bboudaoud/TEMPO-4000/Hardware/Core Platform/Images/TEMPO4_TOP1_recolor.jpg

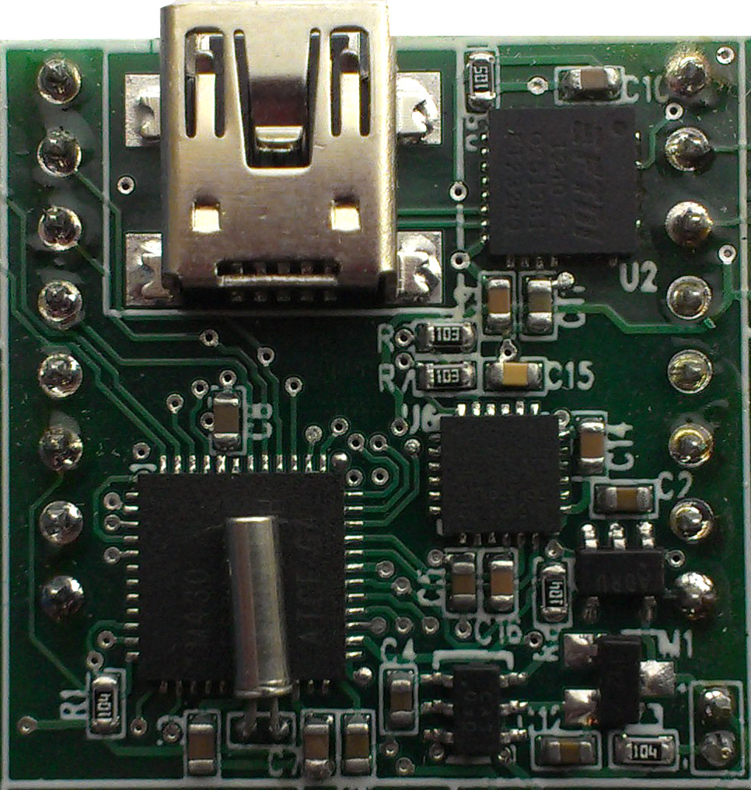
Hardware/Core Platform/Images/TEMPO4_TOP1_recolor.jpg
