bboudaoud/TEMPO-4000/Hardware/Core Platform/Images/1x1board_cam.png

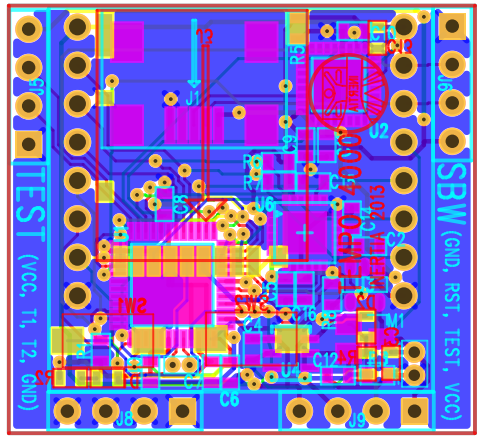
Hardware/Core Platform/Images/1x1board_cam.png
