bboudaoud/TEMPO-4000/Hardware/Core Platform/Images/TEMPO4_BOT1_recolor.jpg

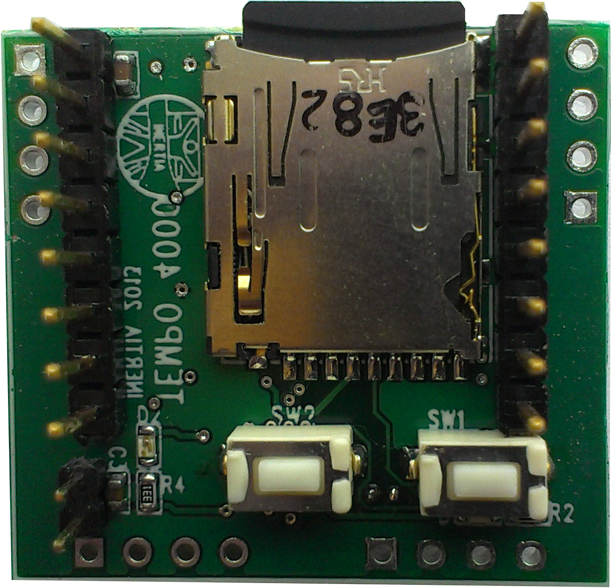
Hardware/Core Platform/Images/TEMPO4_BOT1_recolor.jpg
