bboudaoud/TEMPO-4000/Hardware/Core Platform/Images/TEMPO4_ISO1.jpg

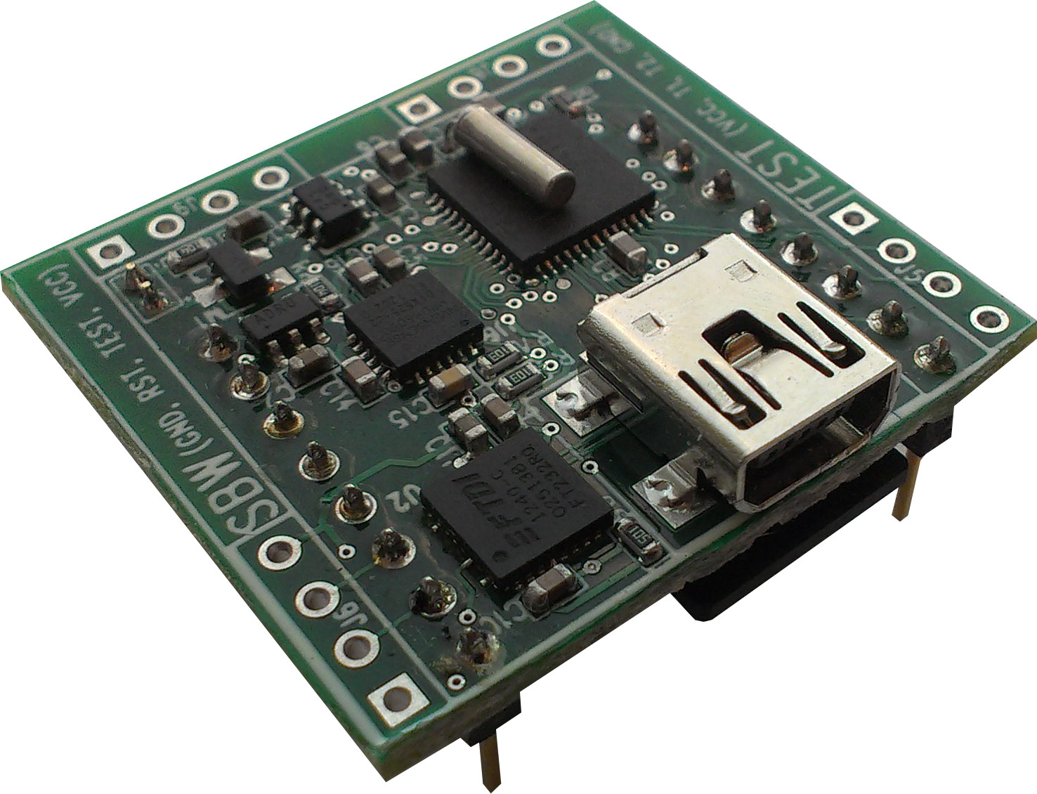
Hardware/Core Platform/Images/TEMPO4_ISO1.jpg
