bboudaoud/TEMPO-4000/Hardware/Core Platform/Images/TEMPO4_TOPBOT_LABEL.jpg

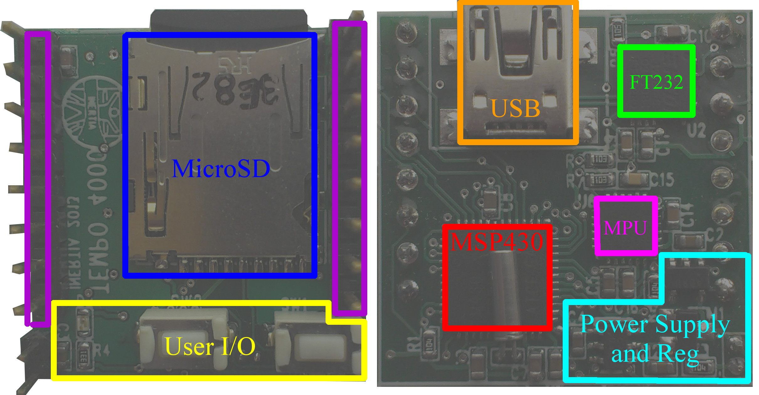
Hardware/Core Platform/Images/TEMPO4_TOPBOT_LABEL.jpg
