bboudaoud/TEMPO-4000/Hardware/Core Platform/TEMPO4k_BoM.xlsx

Item | Reference | Part Name | Qty | Manufacturer | Description | DigiKey Part # | Part Number | Unit Cost @ 1 | Unit Cost @ 10 | Unit Cost @ 100 | Unit Cost | Cost/Board | Total
1 | U4 | AP7312 | 1 | Diodes Inc. | Dual Channel 3.3V 150mA LDO | AP7312-3333W6-7DICT-ND (http://www.digikey.com/product-detail/en/AP7312-3333W6-7/AP7312-3333W6-7DICT-ND/2594053) | AP7312 | $0.64 | $0.56 | $0.43 | 0.56 | 0.56 | 6.72
2 | C9-10 C13-14 C16 | CAP0603_UNDERSIZED,100n | 5 | TDK Corporation | MILSPEC 603 CAPACITOR | 445-1316-1-ND (http://www.digikey.com/product-detail/en/C1608X7R1E104K080AA/445-1316-1-ND/567697) | C1608X7R1E104K080AA | $0.10 | $0.02 | $0.01 | 0.024 | 0.12 | 1.44
3 | C1 C7-8 | CAP0603_UNDERSIZED,10u | 3 | TDK Corporation | MILSPEC 603 CAPACITOR | 445-4112-1-ND (http://www.digikey.com/product-detail/en/C1608X5R0J106M080AB/445-4112-1-ND/1975462) | C1608X5R0J106M080AB | $0.32 | $0.26 | $0.13 | 0.26 | 0.78 | 9.36
4 | C2-5 C12 | CAP0603_UNDERSIZED,1uF | 5 | Samsung Electronics | MILSPEC 603 Capacitor | 1276-1041-1-ND (http://www.digikey.com/product-detail/en/CL10F105ZP8NNNC/1276-1041-1-ND/3889127) | CL10F105ZP8NNNC | $0.10 | $0.04 | $0.02 | 0.041 | 0.205 | 2.46
5 | C15 | CAP0603_UNDERSIZED,2.2nF | 1 | Samsung Electronics | MILSPEC 603 CAPACITOR | 1276-1110-1-ND (http://www.digikey.com/product-detail/en/CL10B222KB8NNNC/1276-1110-1-ND/3889196) | CL10B222KB8NNNC | $0.10 | $0.03 | $0.01 | 0.029 | 0.029 | 0.348
6 | C11 | CAP0603_UNDERSIZED,4.7u | 1 | Taiyo Yuden | MILSPEC 603 CAPACITOR | 587-1785-1-ND (http://www.digikey.com/product-detail/en/JMK107BJ475KA-T/587-1785-1-ND/1212801) | JMK107BJ475KA-T | $0.13 | $0.09 | $0.04 | 0.09 | 0.09 | 1.08
7 | C6 | CAP0603_UNDERSIZED,470nF | 1 | Taiyo Yuden | MILSPEC 603 CAPACITOR | 587-1259-1-ND (http://www.digikey.com/product-detail/en/TMK107F474ZA-T/587-1259-1-ND/931036) | TMK107F474ZA-T | $0.10 | $0.04 | $0.02 | 0.042 | 0.042 | 0.504
8 | J2 | CON-SIP-2P | 1 | N/A | GENERIC 2 PIN SIP HEADER .100 CENTERS | N/A | N/A
9 | J5-6 J8-9 | CON-SIP-4P | 4 | N/A | GENERIC 4 PIN SIP HEADER .100 CENTERS | N/A | N/A
10 | J1 | CON-USB-5PMINI | 1 | TE Connectivity | 5 pin Mini USB type AB connector | 732-3154-1-ND (http://www.digikey.com/product-detail/en/651305142821/732-3154-1-ND/2627307) | 651305142821 | $2.23 | $2.02 | $1.73 | 2.02 | 2.02 | 24.24
11 | X1 | CRYSTAL_0,32.768kHz | 1 | Citizen Finetech Miyota | XTAL 32.768kHz 6pF | 300-8301-ND (http://www.digikey.com/product-search/en?vendor=0&keywords=300-8301-ND) | CFS206-32.768KDZB-UB | $0.28 | $0.24 | $0.16 | 0.24 | 0.24 | 2.88
12 | U2 | FT232RQ | 1 | FTDI | USB to RS232 Converter IC | 768-1008-1-ND (http://www.digikey.com/product-detail/en/FT232RQ-REEL/768-1008-1-ND/1836403) | FT232RQ | $4.50 | $4.05 | $3.65 | 4.05 | 4.05 | 48.6
13 | D1 | LED Green | 1 | Lite-On Inc | MILSPEC 603 LED | 160-1828-1-ND (http://www.digikey.com/product-detail/en/LTST-C193KGKT-5A/160-1828-1-ND/2356247) | LTST-C193KGKT-5A | $0.42 | $0.30 | $0.18 | 0.3 | 0.3 | 3.6
14 | D2 | LED Red | 1 | Lite-On Inc | MILSPEC 603 LED | 160-1830-1-ND (http://www.digikey.com/product-detail/en/LTST-C193KRKT-5A/160-1830-1-ND/2356251) | LTST-C193KRKT-5A | $0.42 | $0.30 | $0.18 | 0.3 | 0.3 | 3.6
15 | U3 | MAX1555EZK-T | 1 | Maxim Integrated | LiPo Battery Charger IC | MAX1555EZK+TCT-ND (http://www.digikey.com/product-detail/en/MAX1555EZK%2BT/MAX1555EZK%2BTCT-ND/2699449) | MAX1555EZK+T | $2.03 | $2.03 | $1.33 | 2.03 | 2.03 | 24.36
16 | J3 | MICROSD_PUSH-PUSH | 1 | Hirose Electric Co Ltd | CONN MICRO SD R/A PUSH-PUSH SMD | HR1964CT-ND (http://www.digikey.com/product-detail/en/DM3AT-SF-PEJM5/HR1964CT-ND/2533566) | DM3AT-SF-PEJM5 | $3.26 | $2.70 | $2.00 | 2.703 | 2.703 | 32.436
17 | U6 | MPU6050 | 1 | Invensense | 6-Axis I2C Interfaced IMU | SPARKFUN or INVENSENSE DIRECTLY (https://www.sparkfun.com/products/10937) | MPU6050 | $12.95 | $11.66 | $10.36 | 11.66 | 11.66 | 139.92
18 | U1 | MSP430F5342 | 1 | Texas Instruments | 5xxx Series MSP430 Microcontroller | 296-29957-1-ND (http://www.digikey.com/product-detail/en/MSP430F5342IRGZT/296-29957-1-ND/2786087) | MSP430F5342 | $6.74 | $6.04 | $3.16 | 6.037 | 6.037 | 72.444
19 | M1 | NDS332P | 1 | Fairchild Semiconductor | SOT-23 P-CH MOSFET | NDS332PCT-ND (http://www.digikey.com/product-detail/en/NDS332P/NDS332PCT-ND/428171) | NDS332P | $0.52 | $0.37 | $0.24 | 0.37 | 0.37 | 4.44
20 | R6-7 | RES0603_UNDERSIZED,10k | 2 | Panasonic Electronic Components | MILSPEC 603 RESISTOR | P10KGCT-ND (http://www.digikey.com/product-detail/en/ERJ-3GEYJ103V/P10KGCT-ND/134717) | ERJ-3GEYJ103V | $0.10 | $0.10 | $0.07 | 0.1 | 0.2 | 2.4
21 | R1, R3, R8 | RES0603_UNDERSIZED,100k | 3 | Panasonic Electronic Components | MILSPEC 603 RESISTOR | P100KGCT-ND (http://www.digikey.com/product-detail/en/ERJ-3GEYJ104V/P100KGCT-ND/134878) | ERJ-3GEYJ104V | $0.10 | $0.10 | $0.01 | 0.1 | 0.3 | 3.6
22 | R5 | RES0603_UNDERSIZED,1M | 1 | Panasonic Electronic Components | MILSPEC 603 RESISTOR | P10KGCT-ND (http://www.digikey.com/product-detail/en/ERJ-3GEYJ103V/P10KGCT-ND/134717) | ERJ-3GEYJ103V | $0.10 | $0.10 | $0.01 | 0.1 | 0.1 | 1.2
23 | R2 R4 | RES0603_UNDERSIZED,330 | 2 | Panasonic Electronic Components | MILSPEC 603 RESISTOR | P330GCT-ND (http://www.digikey.com/product-detail/en/ERJ-3GEYJ331V/P330GCT-ND/134778) | ERJ-3GEYJ331V | $0.10 | $0.10 | $0.01 | 0.1 | 0.2 | 2.4
24 | SW1-2 | SW_PUSHBUTTON | 2 | Panasonic Electronic Components | Momentary Pushbutton SW (SMT) | P13597SCT-ND (http://www.digikey.com/product-detail/en/EVQ-PNF04M/P13597SCT-ND/1245518) | EVQ-PNF04M | $0.72 | $0.68 | $0.52 | 0.677 | 1.354 | 16.248
25 | J4 | T4000HEADER | 1 | N/A | 100 mil TEMPO 4000 16-pin header | N/A | N/A
 | Boards | 12
 | Cost/Board | $33.69
 | Total Cost | $404.28
 | Board Cost | $200
 | Population (unit) | $50
 | Population Total | $600
 | Assembly Total | $1204.28
