bboudaoud/TEMPO-4000/Hardware/Core Platform/Images/testboard_16-pin_devheader.png

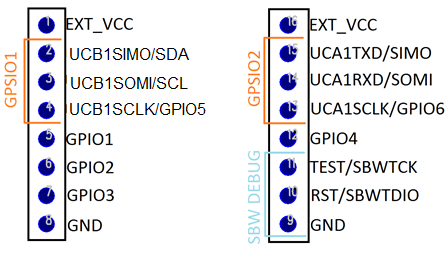
Hardware/Core Platform/Images/testboard_16-pin_devheader.png
