bboudaoud/TEMPO-4000/Hardware/Core Platform/TEMPO4k-final_DFM.pdf

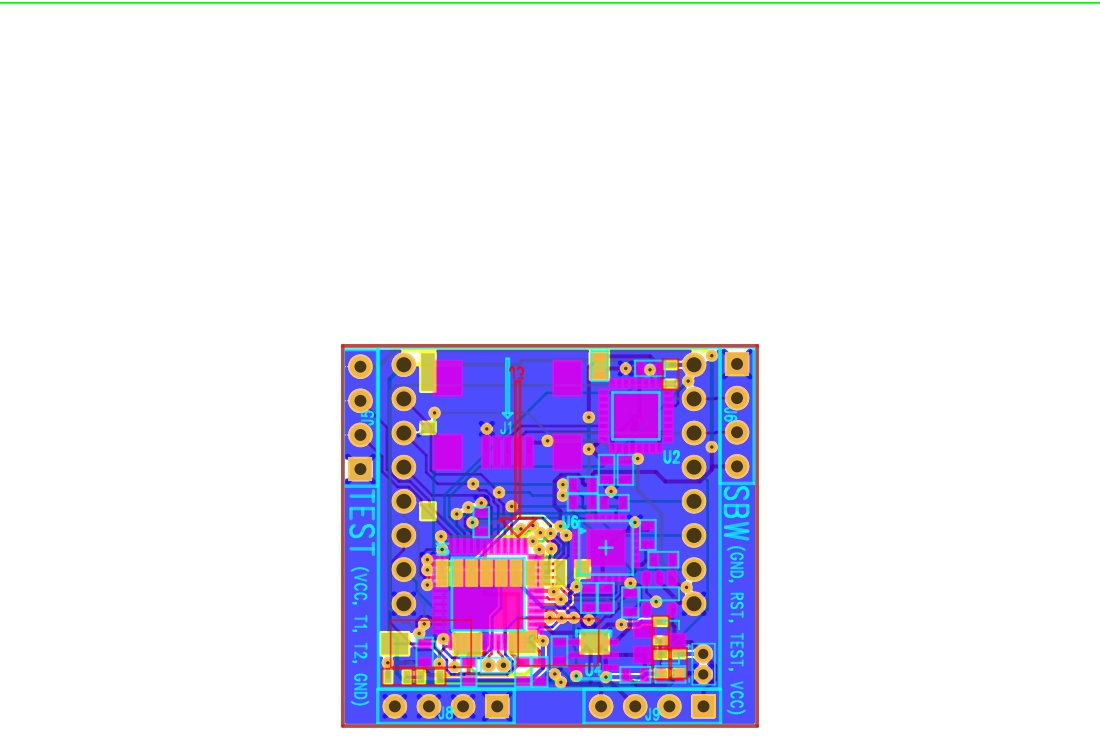
[picture p25: page 1]
