bboudaoud/TEMPO-4000/Hardware/Core Platform/TEMPO4k-final_layout.pdf

# R5R⁵x1 R⁵x2

# C10 C¹⁰x2 C¹⁰x1

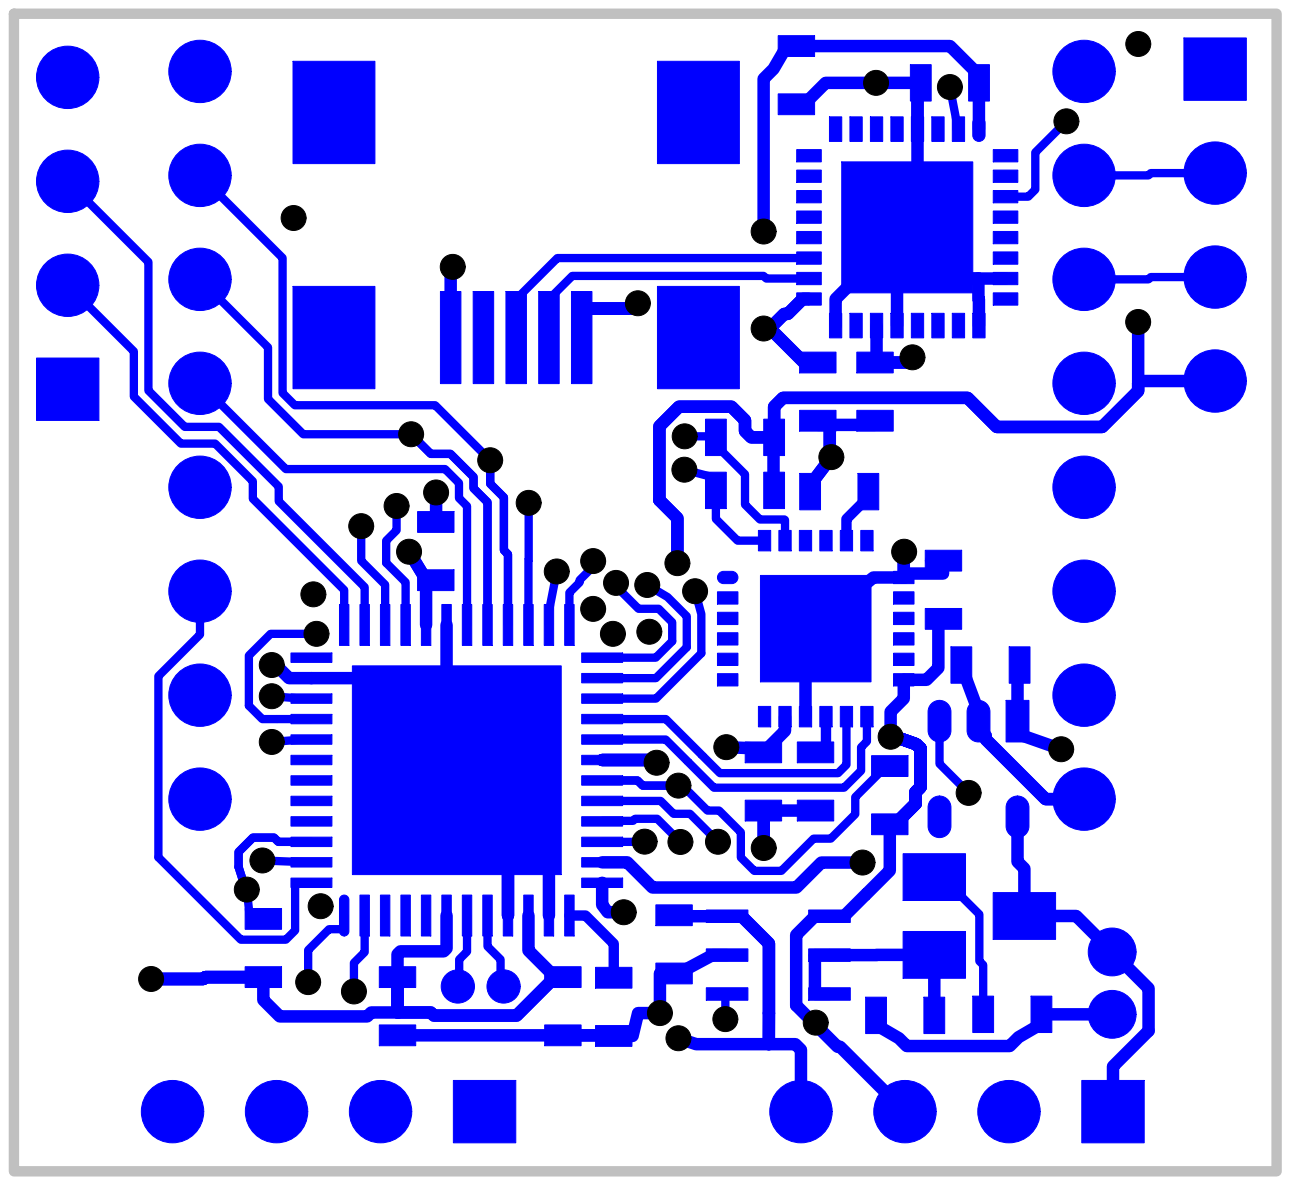
[picture p26: page 1]
U1U¹x1 U¹x2 U¹x3 U¹x4 U¹x5 U¹x6 U¹x7 U¹x8 U¹x9 U¹x10; U¹x11; U¹x12; U2U²x8 U²x7 U²x6 U²x5 U²x4 U²x3 U²x2 U²x1 U²x9 U²x10 U²x11 U²x12 U²x13 U²x14 U²x15 U²x16; U²x17; U²x18; U²x19; U²x20; U²x21; U²x22; U²x23; U²x24 U²x25 U²x26 U²x27 U²x28 U²x29 U²x30 U²x31 U²x32 U²x33; U3U³x3 U³x2 U³x1 U³x4; U³x5; C2C²x2; C²x1; U4U⁴x1 U⁴x2 U⁴x3; U⁴x4 U⁴x5 U⁴x6; C4C⁴x1 C⁴x2; C5C⁵x1 C⁵x2; C12 C¹²x2; C¹²x1; C14C¹⁴x1 C¹⁴x2; C15 C¹⁵x2; C¹⁵x1; C6C⁶x1; C8C⁸x1 J4C⁸x2 J4x1 J4x2 J4x3 J4x4 J4x5 J4x6 J4x7 J4x8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

# J5J5x1 J5x2 J5x3 J5x4

# J6J6x1 J6x2 J6x3 J6x4

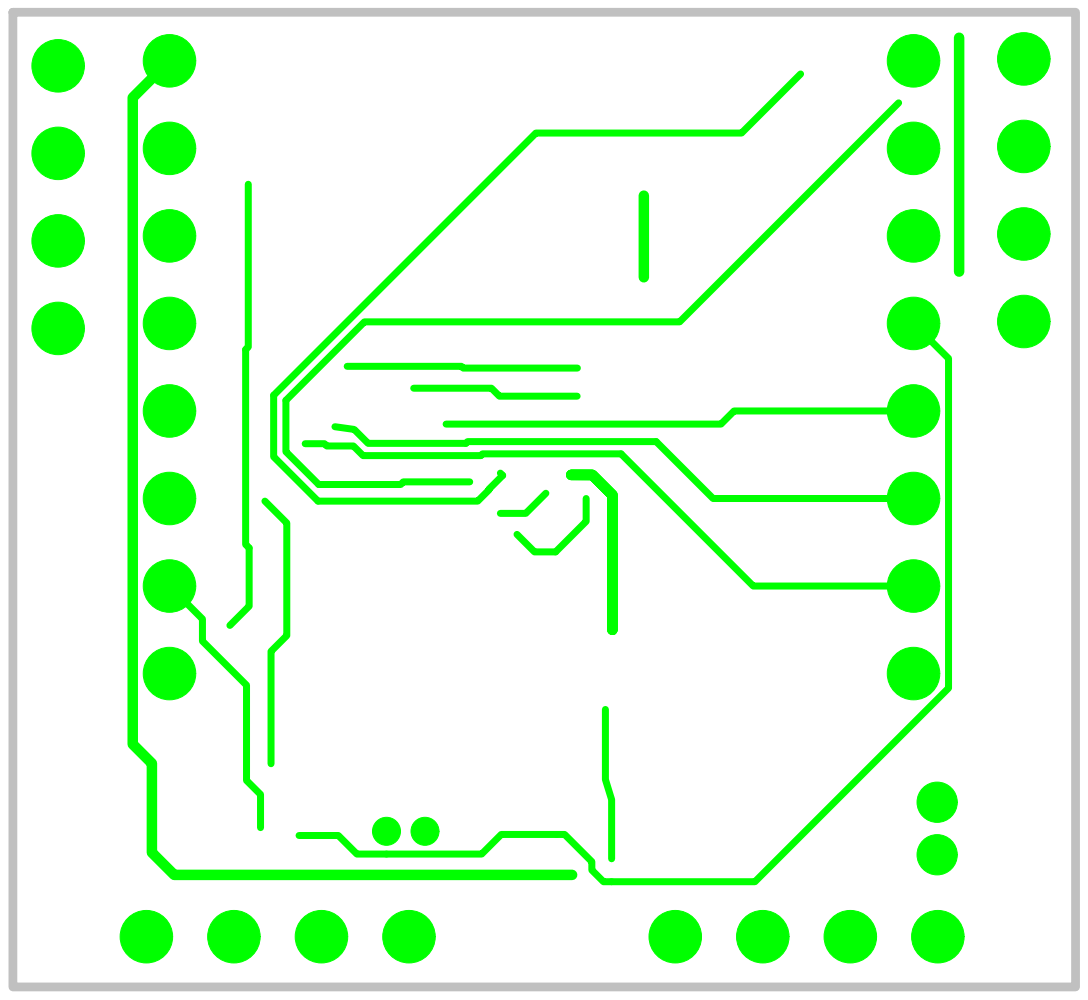
[picture p27: page 2]
X1X¹x2 X¹x1

# J5J5x1 J5x2 J5x3 J5x4

# J6J6x1 J6x2 J6x3 J6x4

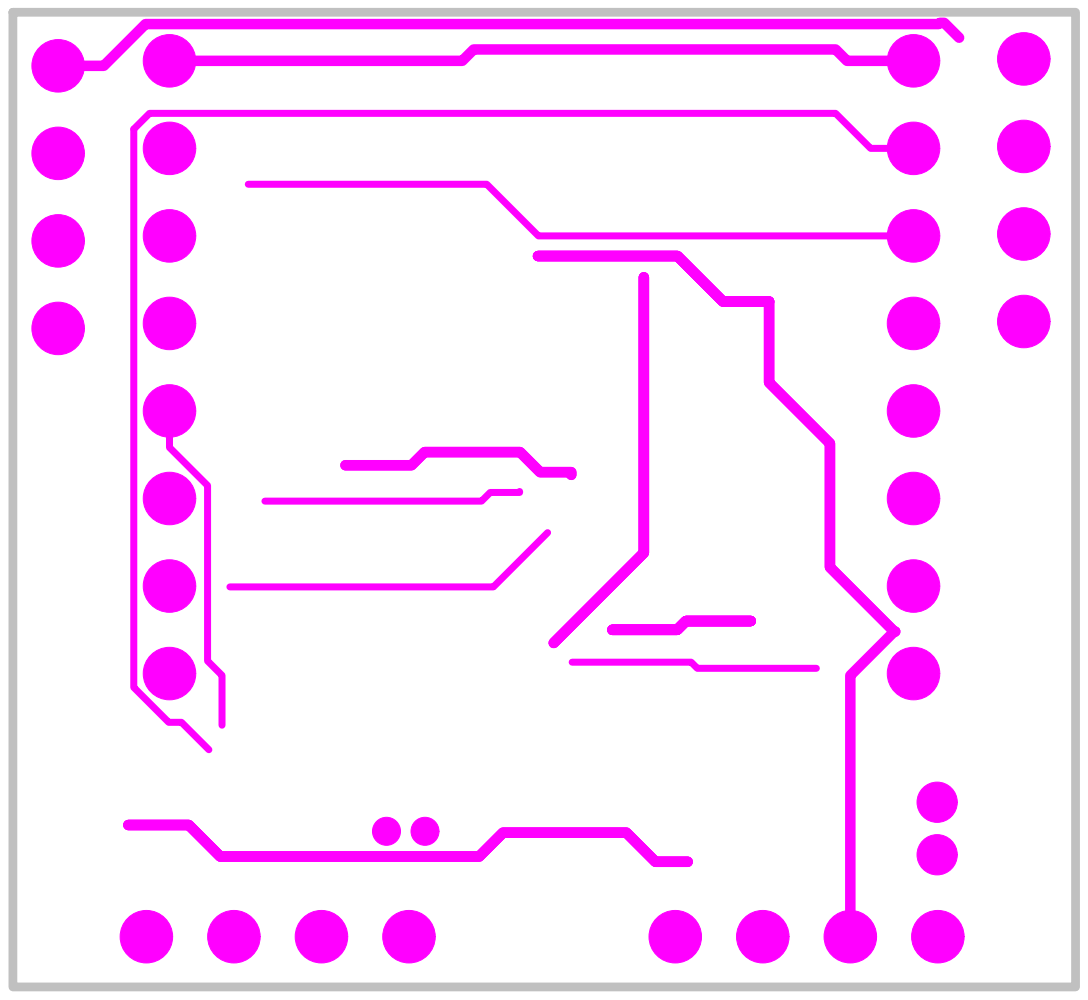
[picture p28: page 3]
X1X¹x2 X¹x1

# C13C¹³x1 C¹³x2

# J5J5x1 J5x2 J5x3 J5x4

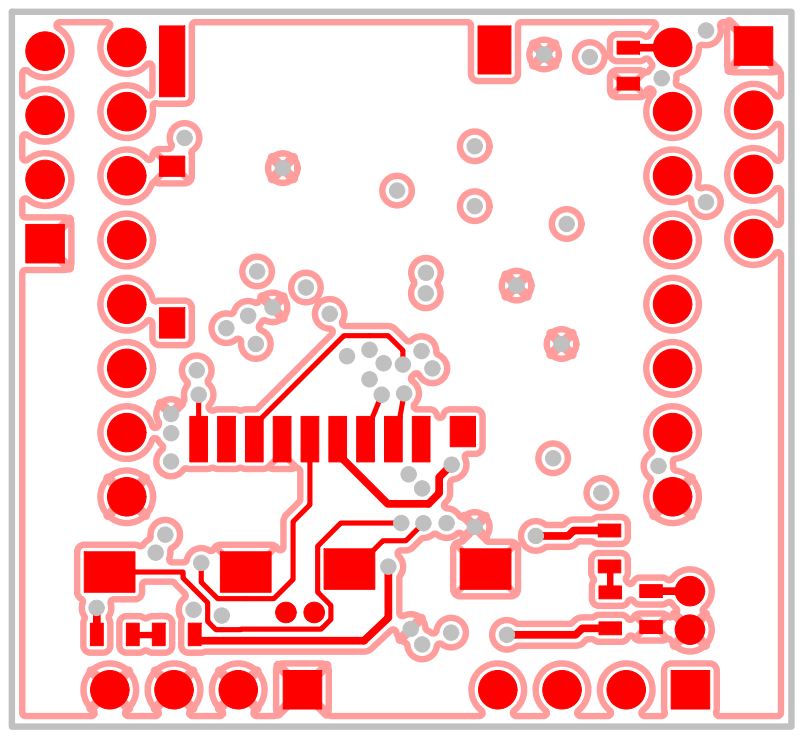
[picture p29: page 4]
C3C³x1 C³x2; D2D²x1; J4D²x2 J4x1 J4x2 J4x3 J4x4 J4x5 J4x6 J4x7 J4x8; X1X¹x2 X¹x1; R2R²x2; R²x1 D1D¹x1; D¹x2; SW2 SW²x1; SW²x2; R4R⁴x1 R⁴x2; SW1 SW¹x1; SW¹x2

R5
C10

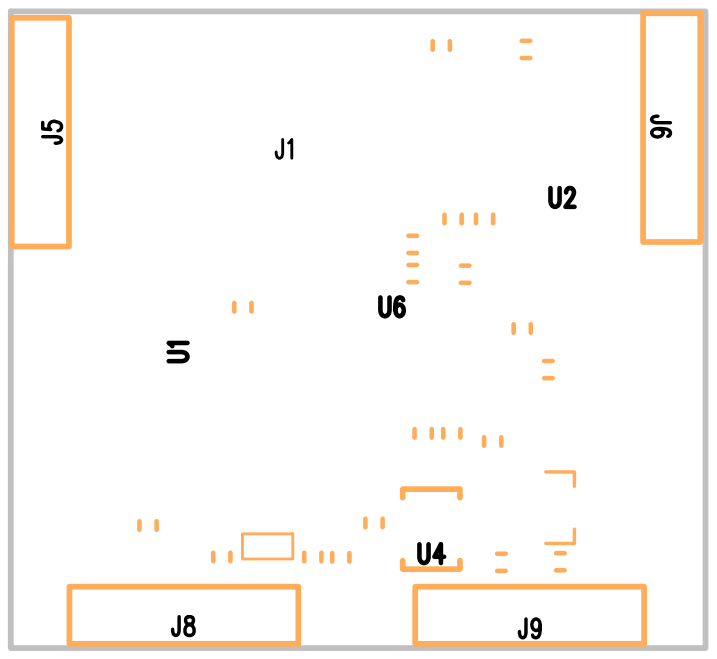
[picture p30: page 5]

J3

C3

D2

C13

# X1X¹x2 X¹x1

R2D1 | J2J2x1 J2x2
SW2 SW1 | R4

C10

1

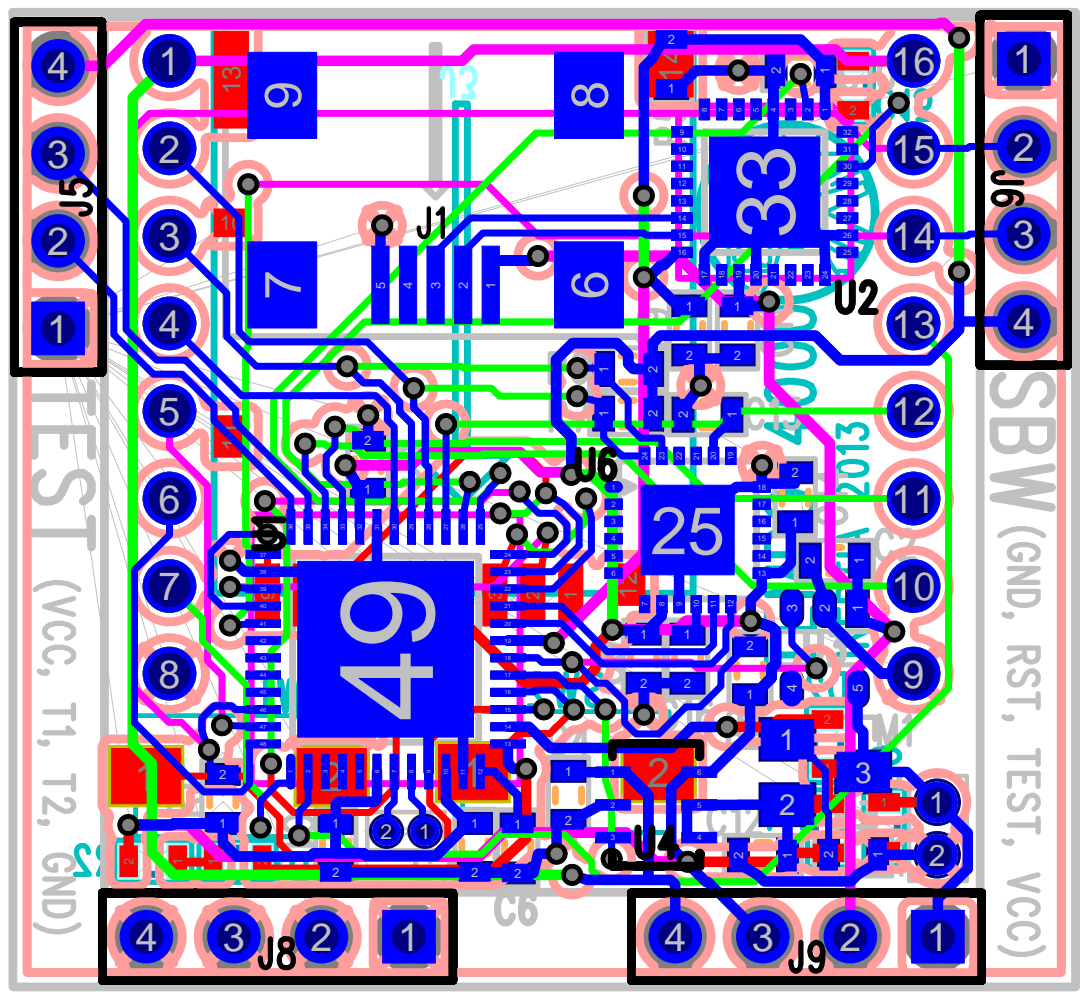
[picture p31: page 7]

SBW (GND, RST, TEST, VCC)
