bboudaoud/TEMPO-4000/Hardware/Core Platform/TEMPO4k-final_schematic.pdf

## MAX1555

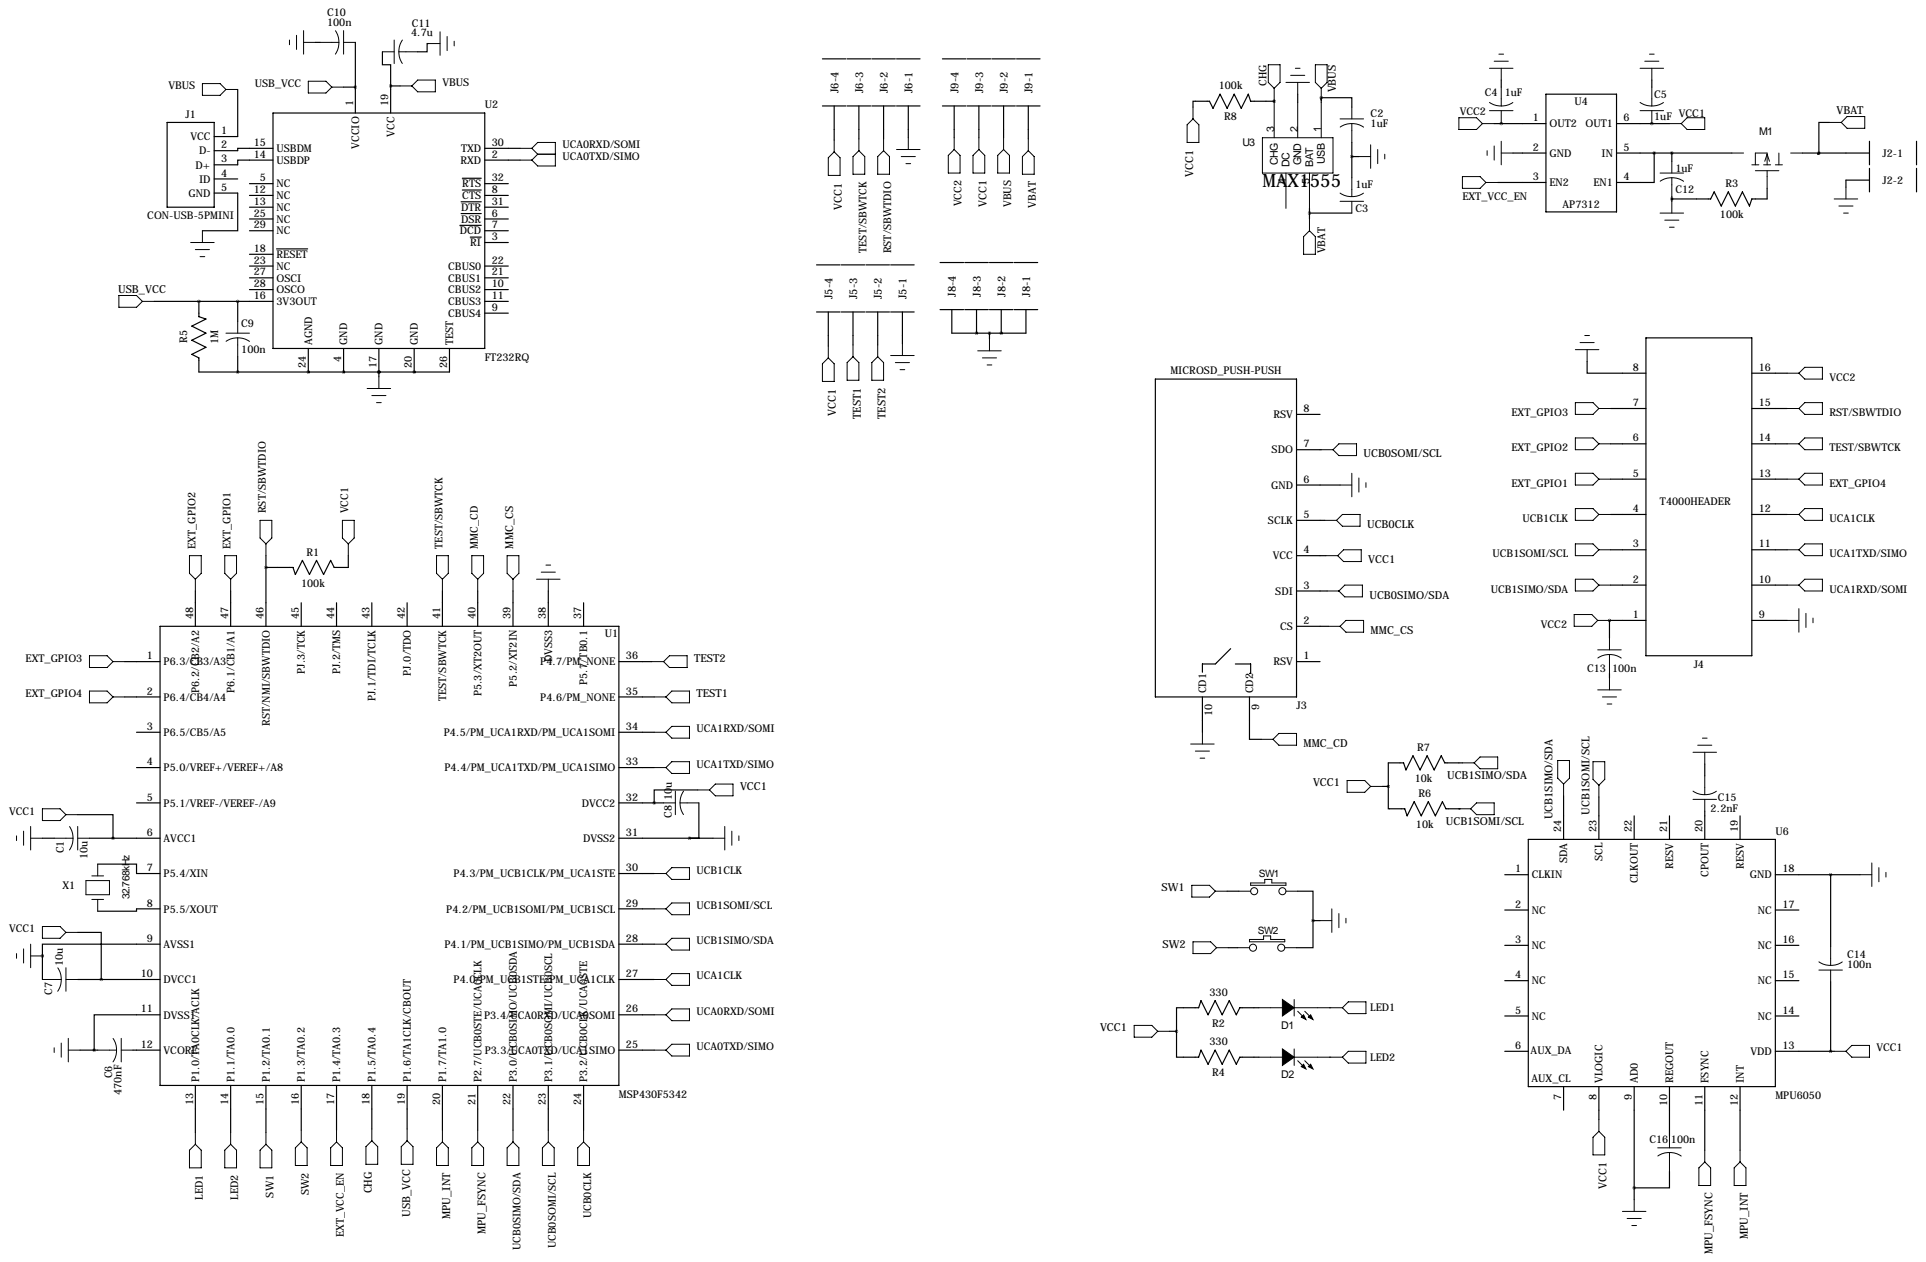
[picture p32: page 1]
