bboudaoud/TEMPO-4000/Hardware/Add ons/BLE/freeDFM_BLE.pdf

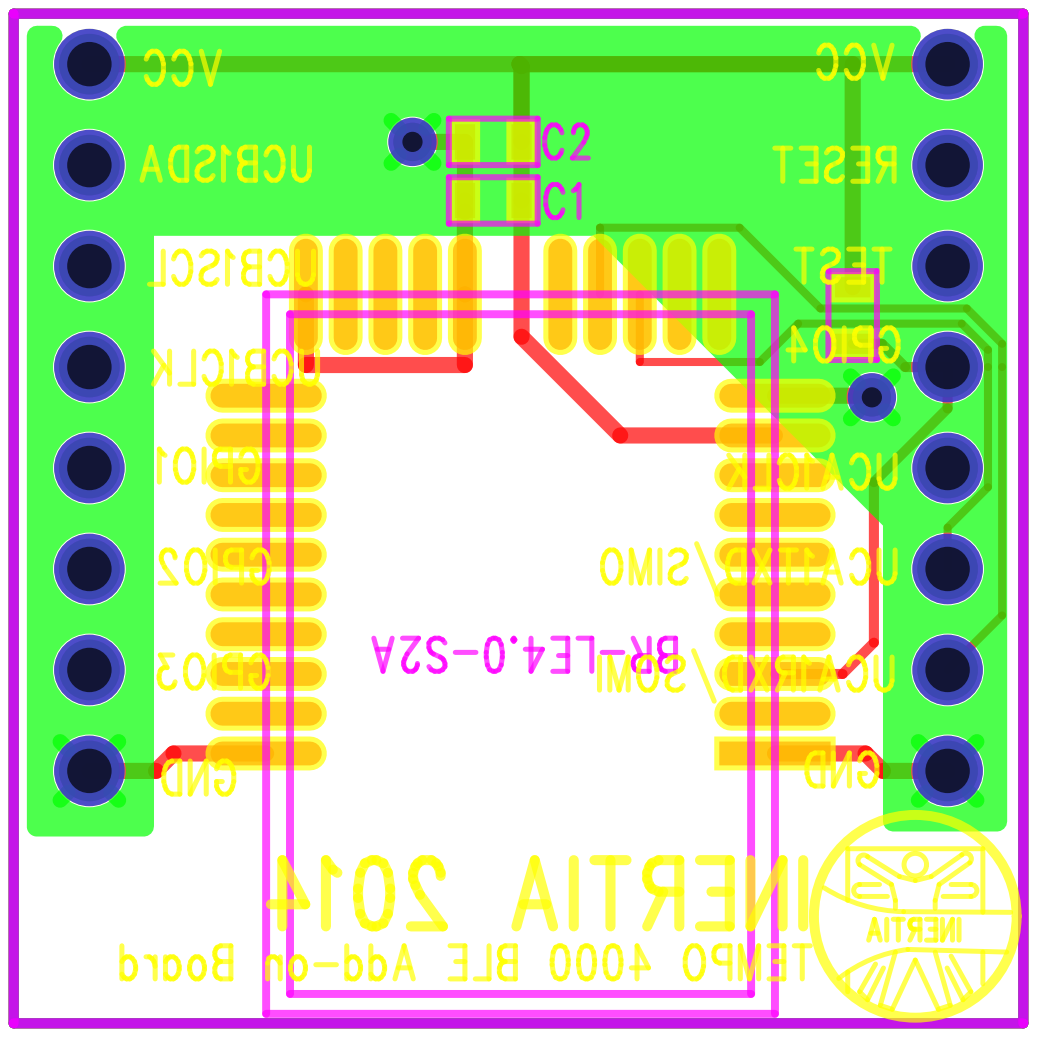
[picture p33: page 1]
