bboudaoud/TEMPO-4000/Hardware/Add ons/ECG/CAM/freeDFM.pdf

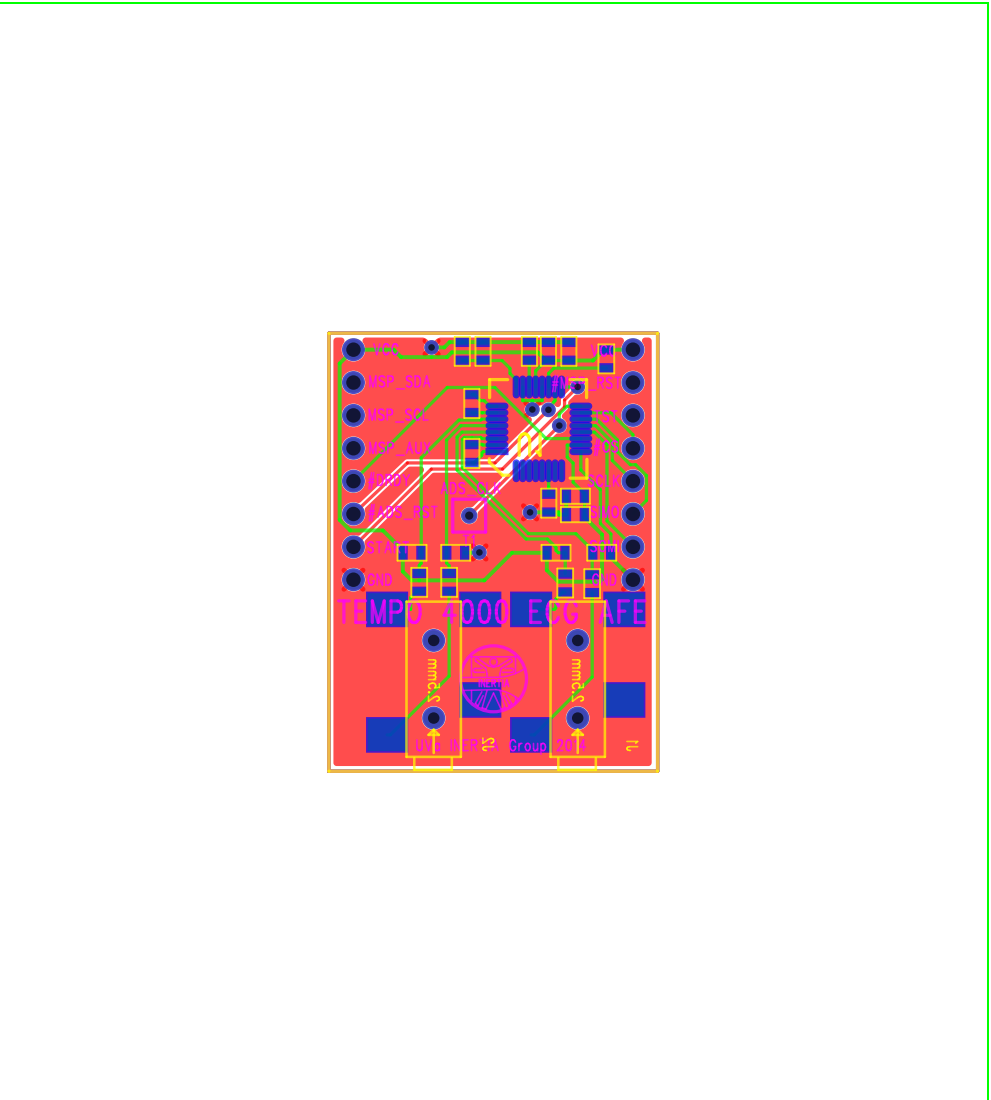
[picture p34: page 1]
