bboudaoud/TEMPO-4000/(list of files, drawings)

Other design files:
Hardware/Add ons/BLE/ble.pcb
Hardware/Add ons/ECG/ecg_layout.pcb
Hardware/Add ons/ECG/ecg_layout_placement.pcb
Hardware/Add ons/ECG/ecg_layout_placement_final.pcb
Hardware/Add ons/Template/template.pcb
Hardware/Core Platform/1x1_test(pour).pcb
Hardware/Core Platform/1x1_test(routed).pcb
Hardware/Core Platform/1x1_test.pcb
